faronramadhan/Smart-Doorlock-Kos-ISK/Test/Firmware/4. Signal Strength/1 Meter—Tanpa Penghalang (Antenna Badag).csv

timestamp | doorlock | port | rssi_dbm
2026-09-17T09:06:44.872 | Doorlock 1 | COM29 | -66
2026-09-17T09:06:44.872 | Doorlock 2 | COM30 | -65
2026-09-17T09:06:44.872 | Doorlock 3 | COM31 | -64
2026-09-17T09:06:44.874 | Doorlock 1 | COM29 | -66
2026-09-17T09:06:45.863 | Doorlock 3 | COM31 | -64
2026-09-17T09:06:45.869 | Doorlock 1 | COM29 | -68
2026-09-17T09:06:45.869 | Doorlock 2 | COM30 | -67
2026-09-17T09:06:45.869 | Doorlock 3 | COM31 | -64
2026-09-17T09:06:45.869 | Doorlock 1 | COM29 | -68
2026-09-17T09:06:45.869 | Doorlock 2 | COM30 | -67
2026-09-17T09:06:45.869 | Doorlock 3 | COM31 | -64
2026-09-17T09:06:45.873 | Doorlock 1 | COM29 | -68
2026-09-17T09:06:45.874 | Doorlock 2 | COM30 | -67
2026-09-17T09:06:46.869 | Doorlock 1 | COM29 | -69
2026-09-17T09:06:46.872 | Doorlock 2 | COM30 | -67
2026-09-17T09:06:46.875 | Doorlock 3 | COM31 | -64
2026-09-17T09:06:46.875 | Doorlock 1 | COM29 | -68
2026-09-17T09:06:46.876 | Doorlock 2 | COM30 | -67
2026-09-17T09:06:46.876 | Doorlock 3 | COM31 | -64
2026-09-17T09:06:46.876 | Doorlock 1 | COM29 | -68
2026-09-17T09:06:47.864 | Doorlock 3 | COM31 | -64
2026-09-17T09:06:47.864 | Doorlock 1 | COM29 | -68
2026-09-17T09:06:47.864 | Doorlock 2 | COM30 | -66
2026-09-17T09:06:47.864 | Doorlock 3 | COM31 | -64
2026-09-17T09:06:47.864 | Doorlock 1 | COM29 | -68
2026-09-17T09:06:47.864 | Doorlock 2 | COM30 | -67
2026-09-17T09:06:47.864 | Doorlock 3 | COM31 | -64
2026-09-17T09:06:47.864 | Doorlock 1 | COM29 | -68
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
2026-09-17T09:07:43.963 | Doorlock 1 | COM29 | -65
2026-09-17T09:07:43.965 | Doorlock 2 | COM30 | -65
2026-09-17T09:07:43.966 | Doorlock 3 | COM31 | -66
2026-09-17T09:07:44.927 | Doorlock 2 | COM30 | -65
2026-09-17T09:07:44.929 | Doorlock 3 | COM31 | -65
