faronramadhan/Smart-Doorlock-Kos-ISK/Test/Firmware/4. Signal Strength/1 Meter—Tanpa Penghalang.csv

timestamp | doorlock | port | rssi_dbm
2026-09-17T08:34:51.200 | Doorlock 1 | COM29 | -46
2026-09-17T08:34:51.200 | Doorlock 2 | COM30 | -40
2026-09-17T08:34:51.201 | Doorlock 3 | COM31 | -40
2026-09-17T08:34:51.822 | Doorlock 1 | COM29 | -45
2026-09-17T08:34:51.822 | Doorlock 2 | COM30 | -39
2026-09-17T08:34:51.998 | Doorlock 3 | COM31 | -40
2026-09-17T08:34:51.998 | Doorlock 1 | COM29 | -45
2026-09-17T08:34:51.998 | Doorlock 2 | COM30 | -39
2026-09-17T08:34:52.000 | Doorlock 3 | COM31 | -40
2026-09-17T08:34:52.200 | Doorlock 1 | COM29 | -45
2026-09-17T08:34:52.200 | Doorlock 2 | COM30 | -40
2026-09-17T08:34:52.201 | Doorlock 3 | COM31 | -42
2026-09-17T08:34:52.692 | Doorlock 3 | COM31 | -44
2026-09-17T08:34:52.692 | Doorlock 1 | COM29 | -47
2026-09-17T08:34:52.692 | Doorlock 2 | COM30 | -43
2026-09-17T08:34:52.993 | Doorlock 1 | COM29 | -49
2026-09-17T08:34:52.993 | Doorlock 2 | COM30 | -43
2026-09-17T08:34:52.993 | Doorlock 3 | COM31 | -42
2026-09-17T08:34:53.200 | Doorlock 1 | COM29 | -49
2026-09-17T08:34:53.200 | Doorlock 2 | COM30 | -43
2026-09-17T08:34:53.200 | Doorlock 3 | COM31 | -43
2026-09-17T08:34:53.836 | Doorlock 1 | COM29 | -49
2026-09-17T08:34:53.836 | Doorlock 2 | COM30 | -44
2026-09-17T08:34:54.002 | Doorlock 3 | COM31 | -44
2026-09-17T08:34:54.003 | Doorlock 1 | COM29 | -50
2026-09-17T08:34:54.003 | Doorlock 2 | COM30 | -44
2026-09-17T08:34:54.004 | Doorlock 3 | COM31 | -44
2026-09-17T08:34:54.205 | Doorlock 1 | COM29 | -46
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
2026-09-17T08:35:48.771 | Doorlock 2 | COM30 | -46
2026-09-17T08:35:49.060 | Doorlock 1 | COM29 | -48
2026-09-17T08:35:49.270 | Doorlock 2 | COM30 | -44
2026-09-17T08:35:49.270 | Doorlock 3 | COM31 | -42
2026-09-17T08:35:49.271 | Doorlock 1 | COM29 | -50
2026-09-17T08:35:49.272 | Doorlock 2 | COM30 | -43
2026-09-17T08:35:49.272 | Doorlock 3 | COM31 | -44
2026-09-17T08:35:49.762 | Doorlock 3 | COM31 | -44
2026-09-17T08:35:49.763 | Doorlock 1 | COM29 | -51
2026-09-17T08:35:49.763 | Doorlock 2 | COM30 | -42
2026-09-17T08:35:50.069 | Doorlock 1 | COM29 | -49
2026-09-17T08:35:50.069 | Doorlock 2 | COM30 | -41
2026-09-17T08:35:50.069 | Doorlock 3 | COM31 | -42
2026-09-17T08:35:50.258 | Doorlock 1 | COM29 | -49
2026-09-17T08:35:50.259 | Doorlock 2 | COM30 | -40
2026-09-17T08:35:50.259 | Doorlock 3 | COM31 | -41
2026-09-17T08:35:50.886 | Doorlock 1 | COM29 | -48
2026-09-17T08:35:50.886 | Doorlock 2 | COM30 | -41
2026-09-17T08:35:51.046 | Doorlock 3 | COM31 | -42
2026-09-17T08:35:51.046 | Doorlock 1 | COM29 | -49
2026-09-17T08:35:51.260 | Doorlock 3 | COM31 | -41
