faronramadhan/Smart-Doorlock-Kos-ISK/Test/Firmware/4. Signal Strength/10 Meter—Beda Lantai.csv

timestamp | doorlock | port | rssi_dbm
2026-09-17T08:56:57.992 | Doorlock 1 | COM29 | -79
2026-09-17T08:56:58.459 | Doorlock 1 | COM29 | -79
2026-09-17T08:56:58.459 | Doorlock 2 | COM30 | -75
2026-09-17T08:56:58.822 | Doorlock 1 | COM29 | -80
2026-09-17T08:56:58.822 | Doorlock 2 | COM30 | -75
2026-09-17T08:56:58.822 | Doorlock 3 | COM31 | -76
2026-09-17T08:56:59.237 | Doorlock 3 | COM31 | -76
2026-09-17T08:56:59.982 | Doorlock 1 | COM29 | -81
2026-09-17T08:56:59.985 | Doorlock 2 | COM30 | -75
2026-09-17T08:56:59.985 | Doorlock 3 | COM31 | -77
2026-09-17T08:56:59.986 | Doorlock 1 | COM29 | -80
2026-09-17T08:56:59.988 | Doorlock 2 | COM30 | -76
2026-09-17T08:56:59.988 | Doorlock 3 | COM31 | -75
2026-09-17T08:57:00.469 | Doorlock 3 | COM31 | -78
2026-09-17T08:57:00.469 | Doorlock 1 | COM29 | -82
2026-09-17T08:57:00.469 | Doorlock 2 | COM30 | -75
2026-09-17T08:57:00.817 | Doorlock 1 | COM29 | -79
2026-09-17T08:57:00.980 | Doorlock 2 | COM30 | -74
2026-09-17T08:57:00.980 | Doorlock 3 | COM31 | -77
2026-09-17T08:57:00.980 | Doorlock 1 | COM29 | -82
2026-09-17T08:57:00.981 | Doorlock 2 | COM30 | -75
2026-09-17T08:57:00.981 | Doorlock 3 | COM31 | -77
2026-09-17T08:57:01.804 | Doorlock 2 | COM30 | -75
2026-09-17T08:57:01.834 | Doorlock 3 | COM31 | -76
2026-09-17T08:57:01.834 | Doorlock 1 | COM29 | -80
2026-09-17T08:57:01.835 | Doorlock 2 | COM30 | -76
2026-09-17T08:57:01.835 | Doorlock 3 | COM31 | -75
2026-09-17T08:57:02.481 | Doorlock 1 | COM29 | -81
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
2026-09-17T08:57:57.533 | Doorlock 2 | COM30 | -77
2026-09-17T08:57:57.533 | Doorlock 3 | COM31 | -73
2026-09-17T08:57:57.861 | Doorlock 2 | COM30 | -78
2026-09-17T08:57:57.861 | Doorlock 3 | COM31 | -76
2026-09-17T08:57:57.861 | Doorlock 1 | COM29 | -85
