faronramadhan/Smart-Doorlock-Kos-ISK/Test/Firmware/4. Signal Strength/6 Meter—Dengan Penghalang (Antenna Badag).csv

timestamp | doorlock | port | rssi_dbm
2026-09-17T09:11:46.014 | Doorlock 1 | COM29 | -76
2026-09-17T09:11:46.016 | Doorlock 2 | COM30 | -72
2026-09-17T09:11:46.224 | Doorlock 1 | COM29 | -78
2026-09-17T09:11:46.224 | Doorlock 2 | COM30 | -72
2026-09-17T09:11:46.430 | Doorlock 1 | COM29 | -78
2026-09-17T09:11:46.430 | Doorlock 2 | COM30 | -70
2026-09-17T09:11:46.645 | Doorlock 1 | COM29 | -77
2026-09-17T09:11:46.645 | Doorlock 2 | COM30 | -71
2026-09-17T09:11:46.901 | Doorlock 1 | COM29 | -81
2026-09-17T09:11:46.901 | Doorlock 2 | COM30 | -72
2026-09-17T09:11:46.901 | Doorlock 3 | COM31 | -80
2026-09-17T09:11:46.901 | Doorlock 1 | COM29 | -79
2026-09-17T09:11:46.904 | Doorlock 2 | COM30 | -72
2026-09-17T09:11:46.904 | Doorlock 3 | COM31 | -82
2026-09-17T09:11:47.321 | Doorlock 3 | COM31 | -82
2026-09-17T09:11:47.388 | Doorlock 1 | COM29 | -73
2026-09-17T09:11:47.398 | Doorlock 2 | COM30 | -71
2026-09-17T09:11:47.398 | Doorlock 3 | COM31 | -88
2026-09-17T09:11:47.894 | Doorlock 3 | COM31 | -78
2026-09-17T09:11:47.894 | Doorlock 1 | COM29 | -74
2026-09-17T09:11:47.894 | Doorlock 2 | COM30 | -72
2026-09-17T09:11:47.894 | Doorlock 3 | COM31 | -79
2026-09-17T09:11:47.894 | Doorlock 1 | COM29 | -73
2026-09-17T09:11:47.894 | Doorlock 2 | COM30 | -73
2026-09-17T09:11:48.395 | Doorlock 2 | COM30 | -71
2026-09-17T09:11:48.395 | Doorlock 3 | COM31 | -77
2026-09-17T09:11:48.395 | Doorlock 1 | COM29 | -75
2026-09-17T09:11:48.897 | Doorlock 1 | COM29 | -75
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
2026-09-17T09:12:43.573 | Doorlock 2 | COM30 | -69
2026-09-17T09:12:43.949 | Doorlock 1 | COM29 | -83
2026-09-17T09:12:43.949 | Doorlock 2 | COM30 | -69
2026-09-17T09:12:43.954 | Doorlock 3 | COM31 | -80
2026-09-17T09:12:43.954 | Doorlock 1 | COM29 | -84
2026-09-17T09:12:43.955 | Doorlock 2 | COM30 | -69
2026-09-17T09:12:43.955 | Doorlock 3 | COM31 | -81
2026-09-17T09:12:44.368 | Doorlock 3 | COM31 | -82
2026-09-17T09:12:44.453 | Doorlock 1 | COM29 | -80
2026-09-17T09:12:44.453 | Doorlock 2 | COM30 | -71
2026-09-17T09:12:44.453 | Doorlock 3 | COM31 | -83
2026-09-17T09:12:44.961 | Doorlock 3 | COM31 | -86
2026-09-17T09:12:44.961 | Doorlock 1 | COM29 | -78
2026-09-17T09:12:44.963 | Doorlock 2 | COM30 | -72
2026-09-17T09:12:45.166 | Doorlock 1 | COM29 | -77
2026-09-17T09:12:45.166 | Doorlock 2 | COM30 | -71
2026-09-17T09:12:45.453 | Doorlock 1 | COM29 | -78
2026-09-17T09:12:45.453 | Doorlock 2 | COM30 | -70
2026-09-17T09:12:45.458 | Doorlock 3 | COM31 | -81
