faronramadhan/Smart-Doorlock-Kos-ISK/Test/Firmware/4. Signal Strength/6 Meter—Dengan Penghalang.csv

timestamp | doorlock | port | rssi_dbm
2026-09-17T08:41:44.220 | Doorlock 1 | COM29 | -51
2026-09-17T08:41:44.220 | Doorlock 2 | COM30 | -53
2026-09-17T08:41:44.220 | Doorlock 3 | COM31 | -60
2026-09-17T08:41:44.220 | Doorlock 1 | COM29 | -51
2026-09-17T08:41:44.220 | Doorlock 2 | COM30 | -53
2026-09-17T08:41:44.429 | Doorlock 1 | COM29 | -49
2026-09-17T08:41:44.429 | Doorlock 2 | COM30 | -52
2026-09-17T08:41:45.168 | Doorlock 3 | COM31 | -60
2026-09-17T08:41:45.183 | Doorlock 1 | COM29 | -50
2026-09-17T08:41:45.183 | Doorlock 2 | COM30 | -52
2026-09-17T08:41:45.378 | Doorlock 3 | COM31 | -63
2026-09-17T08:41:45.378 | Doorlock 1 | COM29 | -47
2026-09-17T08:41:45.382 | Doorlock 2 | COM30 | -50
2026-09-17T08:41:45.594 | Doorlock 1 | COM29 | -50
2026-09-17T08:41:45.594 | Doorlock 2 | COM30 | -52
2026-09-17T08:41:46.187 | Doorlock 2 | COM30 | -51
2026-09-17T08:41:46.187 | Doorlock 3 | COM31 | -65
2026-09-17T08:41:46.187 | Doorlock 1 | COM29 | -52
2026-09-17T08:41:46.190 | Doorlock 2 | COM30 | -51
2026-09-17T08:41:46.190 | Doorlock 3 | COM31 | -65
2026-09-17T08:41:46.190 | Doorlock 1 | COM29 | -52
2026-09-17T08:41:46.399 | Doorlock 2 | COM30 | -52
2026-09-17T08:41:46.399 | Doorlock 3 | COM31 | -65
2026-09-17T08:41:46.399 | Doorlock 1 | COM29 | -51
2026-09-17T08:41:47.185 | Doorlock 2 | COM30 | -51
2026-09-17T08:41:47.185 | Doorlock 3 | COM31 | -60
2026-09-17T08:41:47.192 | Doorlock 1 | COM29 | -51
2026-09-17T08:41:47.192 | Doorlock 2 | COM30 | -51
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
2026-09-17T08:42:43.434 | Doorlock 2 | COM30 | -55
2026-09-17T08:42:43.434 | Doorlock 3 | COM31 | -66
2026-09-17T08:42:43.434 | Doorlock 1 | COM29 | -51
2026-09-17T08:42:44.242 | Doorlock 2 | COM30 | -55
2026-09-17T08:42:44.244 | Doorlock 3 | COM31 | -62
