faronramadhan/Smart-Doorlock-Kos-ISK/Hardware/Doorlock/Doorlock Wiring Diagram.pdf

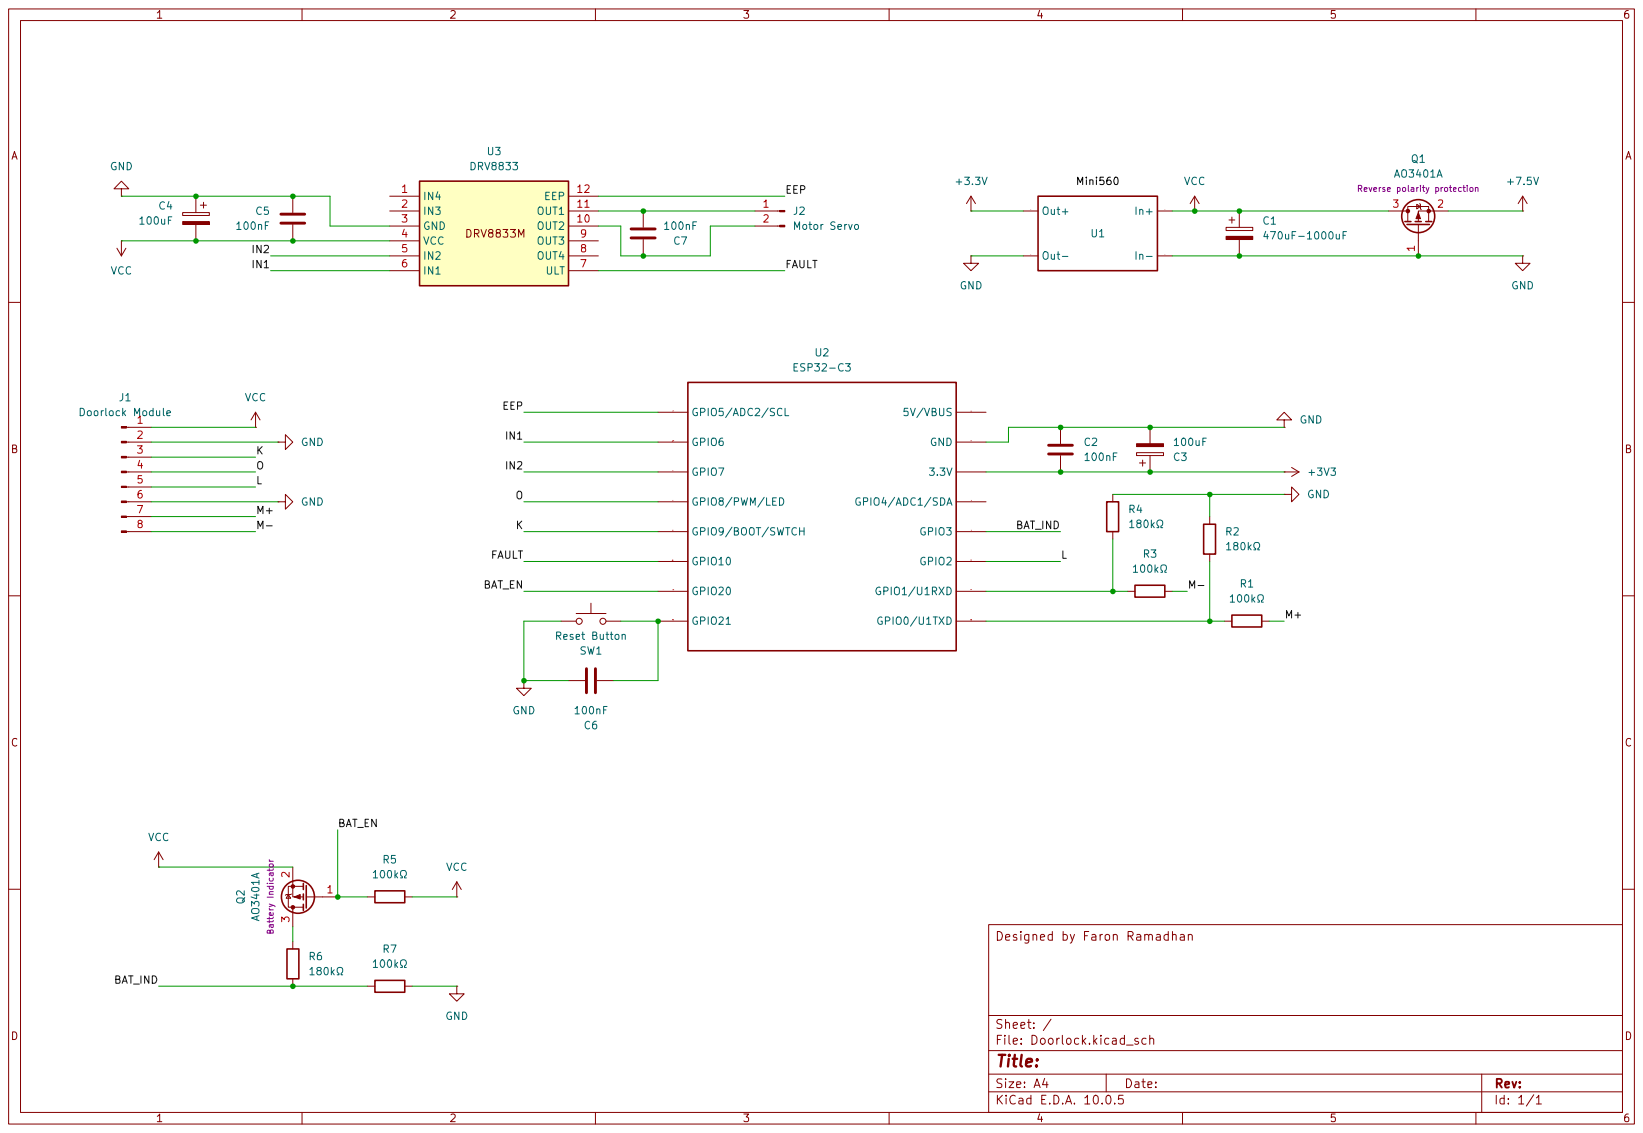
[picture p1: page 1]
