faronramadhan/Smart-Doorlock-Kos-ISK/Hardware/Gateway/Gateway Wiring Diagram.pdf

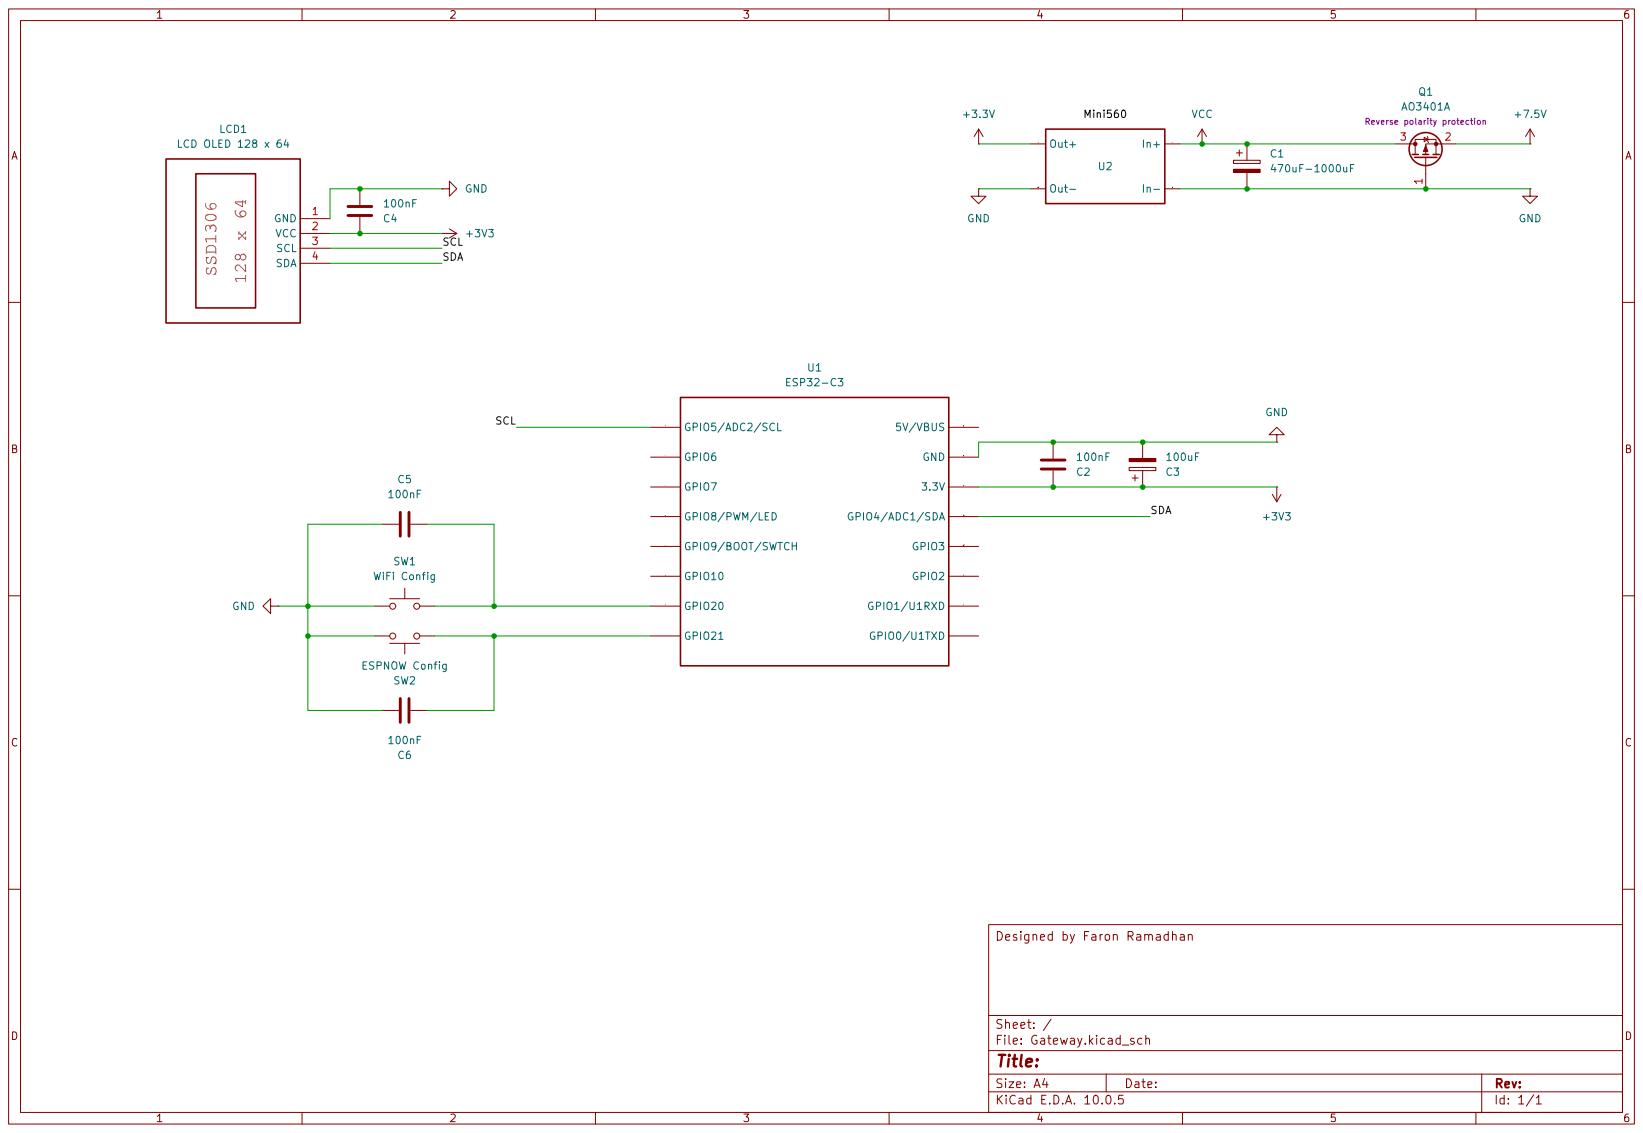
[picture p2: page 1]
