faronramadhan/Smart-Doorlock-Kos-ISK/Hardware/Doorlock/Doorlock/Doorlock.kicad_sch

## KiCad design Hardware/Doorlock/Doorlock/Doorlock.kicad_sch (2026-09-01)

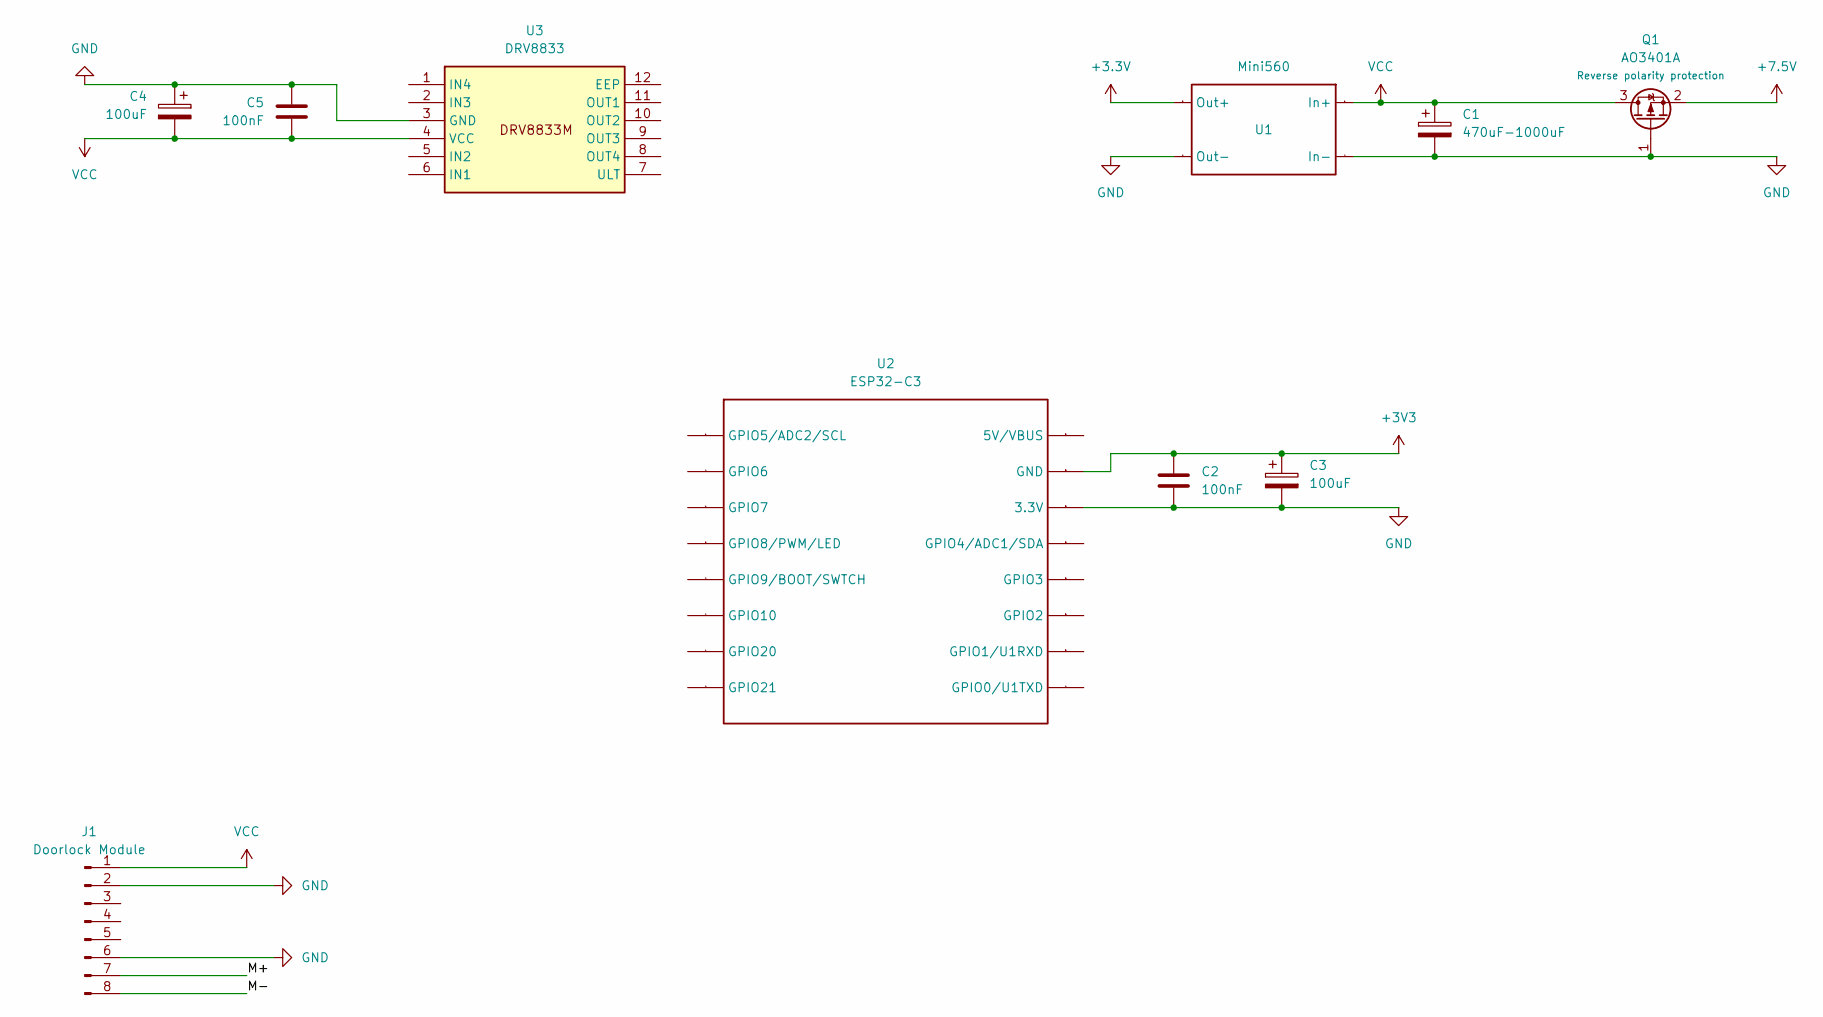
[picture p3: schematic Doorlock.kicad_sch]

Parts:
C1: 470uF-1000uF
C2, C5: 100nF
C3, C4: 100uF
J1: Doorlock Module
Q1: AO3401A; SOT-23
U1: Mini560
U2: ESP32-C3
U3: DRV8833

Connections:
+3.3V: U1.4 (Out+)
+3V3: C2.1, C3.1, U2.15 (GND)
+7.5V: Q1.2 (S)
GND: C1.2, C2.2, C3.2, C4.1, C5.1, J1.2, J1.6, Q1.1 (G), U1.2 (In-), U1.3 (Out-), U2.14 (3.3V), U3.3 (GND)
M+: J1.7
M-: J1.8
VCC: C1.1, C4.2, C5.2, J1.1, Q1.3 (D), U1.1 (In+), U3.4 (VCC)
