faronramadhan/Smart-Doorlock-Kos-ISK/(commit log)

2026-08-23 Update platformio.ini to set monitor and upload speeds for ESP32 development
2026-09-01 feat(doorlock): Buat file *kicad dan wiring power distribution.
    [Doorlock.kicad_sch]
2026-09-01 refactor(doorlock): Memperbaiki struktur folder Hardware
    [Doorlock.kicad_sch]
2026-09-01 feat(doorlock): Rangkaian RFID reader dan kontrol motor.
    [Doorlock.kicad_sch]
2026-09-01 feat(doorlock): Battery indicator.
    [Doorlock.kicad_sch]
2026-09-03 feat(doorlock): Wiring finish!
    [Doorlock.kicad_sch]
2026-09-03 feat(gateway): Wiring finish!
    [Gateway.kicad_pcb, Gateway.kicad_sch]
2026-09-03 fix(doorlock): Power flag kebalik, cuy.
    [Doorlock.kicad_sch]
2026-09-04 docs(wiring diagram): Doorlock and Gateway Ver. 1
    [Doorlock.kicad_sch, Gateway.kicad_sch]
2026-09-06 test(espnow): Connecting 2 ESP devices.
2026-09-13 fix(website): perbaiki bug approval admin & simpan rules Firebase
    Panel persetujuan kini menampilkan pendaftar baru dan rules database disimpan di repo.
2026-09-16 test(signal): Pengujian kekuatan sinyal jarak 0 meter.
    [0 Langkah.csv]
2026-09-16 test(signal): Pengujian kekuatan sinyal jarak 5 meter.
    [5 Langkah.csv]
2026-09-16 refactor(website): hapus wrapper floors/gateways di database
    Key lantai dan gateway langsung pakai nama, skema lama dimigrasikan otomatis.
2026-09-16 refactor(website): hapus field createdAt di lantai/gateway
    Field createdAt tidak ditulis lagi dan data lama dibersihkan otomatis.
2026-09-17 test(signal): Pengujian kekuatan sinyal!
    [0 Langkah.csv, 1 Meter—Tanpa Penghalang (Antenna Badag).csv, 1 Meter—Tanpa Penghalang.csv, 10 Meter—Beda Lantai.csv, 5 Langkah.csv, 6 Meter—Dengan Penghalang (Antenna Badag).csv, 6 Meter—Dengan Penghalang.csv]
2026-09-26 feat(hardware): Revisi rangkaian indikator baterai.
    [Doorlock.kicad_sch]
2026-09-26 test(battery): Pengujian indikator baterai
    Hasil baca tegangan baterai dari firmware dibandingkan dengan multimeter, selisihnya sekitar 3%.
2026-09-27 refactor(website): riwayat disimpan di localStorage, bukan Firebase
    Node history lama di Firebase dipindahkan otomatis ke localStorage lalu dihapus saat dashboard dibuka.
2026-09-27 feat(hardware): Revisi divider M+/M- dan indikator baterai.
    Divider M+/M- jadi 200k/100k (rasio 3), R6 indikator baterai jadi 200k, dan label M+/M- di konektor Doorlock Module ditukar sesuai wiring.
2026-09-27 test(rfid): Pengujian output RFID.
    Output modul original berupa pulsa ~6.18 V selama ~300-350 ms tanpa PWM, M- lalu M+ bergantian.
2026-09-27 feat(gateway): Pairing WiFi dan Doorlock lewat button dan OLED
    WiFi diatur lewat hotspot dan doorlock dipairing satu per satu lewat konfirmasi di OLED.
2026-09-27 feat(doorlock): Masuk mode pairing lewat button.
    Balikin firmware ESP-NOW (sebelumnya diganti program test) dan tambah SW1 ditahan 5 detik buat mulai broadcast pairing ke Gateway.
2026-09-27 feat(firmware): pendaftaran otomatis gateway & dummy semua kamar
    Gateway baru otomatis terdaftar ke Firebase dan dummy doorlock bisa dipakai di semua kamar.
2026-09-27 docs: Daftarkan EVT_RFID_REJECTED di Object Dictionary
    Kode 0x14 dikirim doorlock ke gateway saat kartu RFID ditempel tapi
    ditolak karena rfidAccess = false.
2026-09-27 feat(gateway): Pairing lewat LCD dan slot doorlock
    Gateway fokus ke ESP-NOW dengan pairing lewat LCD, slot doorlock tetap, dan balasan ALLOW/BLOCK.
2026-09-29 feat(doorlock): Cek ALLOW/BLOCK, baterai, dan motor
    Doorlock minta ALLOW/BLOCK ke gateway di setiap pulsa M+/M-, script log Test 7 ikut diperbarui.
